kadets90/Real-Time-Cooperative-Decentralized-Control-of-Illumination-Systems-/relatorio.pdf

Instituto Superior Tecnico ´

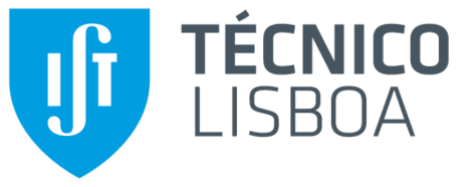
[picture p1: figure]

Sistemas de Controlo Distribuído em

Tempo-Real

### MEEC

2019/2020 - 5o Ano, 1o Semestre

# Real-Time Cooperative Decentralized Control of Illumination Systems

Grupo 20

## Eduardo Pereira David Ribeiro

79640
84027

## Docentes: Alexandre José Malheiro Bernardino João Pedro Castilho Pereira Santos Gomes Ricardo Adriano Ribeiro

10 de Janeiro de 2020

Sistemas de Controlo Distribuído em Tempo-Real 2019/2020

## Conteúdo

1 Introdução | 1
2 Arquitetura do sistema | 2
3 Inicialização do sistema | 6
4 Controlo | 8
5 Comunicações | 10
6 Resultados | 12
7 Conclusão | 15
8 Divisão do trabalho | 16

Sistemas de Controlo Distribuído em Tempo-Real 2019/2020

Resumo

Este relatório mostra uma proposta para a minimização do consumo de energia da simulação de um escritório baseada num sistema de controlo distribuído. Cada posto de trabalho é composto por um micro-controlador, um LED e uma foto-resistência. O algoritmo consensus é utilizado no cálculo dos duty cycles a serem usados nos LED para um consumo mínimo de energia mas satisfazendo os valores de luminosidade em cada posto de trabalho. Foi também desenvolvido um controlador local para que o sistema consiga reagir a perturbações exteriores. Os arduinos comunicam entre si através do uso do Can bus e com uma aplicação desenvolvida em C++, permite ao utilizador enviar comandos para o sistema através de comunicação série.

Palavras-chave— controlo distribuído, consensus, tempo-real, eficiência energética, arduino

## 1 Introdução

Devido ao elevado consumo energético em escritórios para efeitos de iluminação, este projecto tem como objectivo apresentar uma solução mais viável tanto economicamente, como financeiramente, sem afectar a qualidade da iluminação disponível.

Neste trabalho o objectivo é desenvolver um sistema de iluminarias, com um sensor de luminância e o um sensor de presença associados a cada, que, respeitando os valores mínimos impostos pela norma EN 12464-1, optimize a energia consumida pelo sistema. Para tal é utilizado um sistema de controlo descentralizado, onde cada luminária terá uma referência de duty cicle independente, o qual influencia proporcionalmente a potência consumida. Estas referencias são calculadas a partir do algoritmo de controlo descentralizado consensus. Para garantir que a luminância é mantida ao longo do tempo, mesmo na presença de perturbações e/ou iluminação externa, luz do sol a variar ao longo do dia através de uma janela, por exemplo, é utilizado um controlador proporcional integral local em cada ponto, de forma a que a o valor de luminância seja o mais constante possível. Para a leitura do valor da luminância e respectiva actuação e controlo local será utilizado um arduino em cada ponto. Os arduinos comunicam entre si por CAN bus, e a um computador através de comunicação série.

Sistemas de Controlo Distribuído em Tempo-Real 2019/2020

## 2 Arquitetura do sistema

## 2.1 Circuito

Para simular as luminárias presentes num escritório, usa-se o circuito apresentado na Figura 1. Para se poder monitorizar a quantidade usa-se o circuito recetor também na Figura 1, através do uso de um LDR, resistência dependente de luz. O valor desta resistência em função da luz aplicada na resistência é dada por

LDR(x) = 10m∗log10 x+b
, | (1)

em que m e b representam respetivamente o declive da característica Iluminância/Resistência, que na escala logarítmica é linear, e a interseção do declive no eixo da resistência. Como o processo de fabricação dos LDR não é muito rigoroso, estes dois valores variam dentro de uma certa gama de valores fornecidos na folha de especificações do LDR. Por isso, os valores de m e b foram determinados de forma a se obter uma uma relação entre duty cycle e iluminância o mais linear possível, e que as leituras dos dois sensores fossem semelhantes para a mesma de luz.

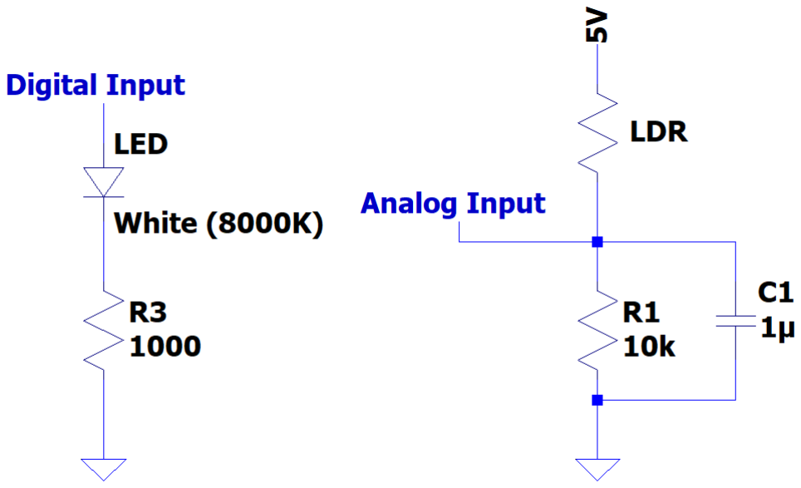
[picture p2: figure]

Figura 1: Esquemático do circuito emissor, à esquerda, e o circuito recetor à direita

Como a variação de iluminância faz variar o valor da foto-resistência, é preciso utilizar um circuito para que o arduino consiga medir esta variação de forma a obter depois a iluminância. Com o circuito recetor, verifica-se que a tensão medida na entrada analógica pode ser obtida utilizando um divisor de tensão é dada por

Sistemas de Controlo Distribuído em Tempo-Real 2019/2020

v = Vcc − i ∗ LDR(x), | (2)

em que x é a iluminância em lux que o LDR capta, Vcc é novamente a tensão de alimentação do circuito e i é a corrente que passa no LDR, que por sua vez é dada pela soma da corrente na resistência R1 e no condensador C1, ou seja,

i =

v
R1

+ C1 ∗

∂v
∂t . | (3)

Ao substituir 3 em 2, resulta em

v˙ ∗ τ (x) = −v + Vcc ∗

R1
R1 + LDR(x)
, | (4)

em que τ (x) é dado por
τ (x) = R1 ∗ LDR(x)
R1 + LDR(x)
∗ C1. | (5)

Resolver a equação diferencial em 4, resulta em

v(t) = vf − (vf − vi) exp −

t − ti
τ (xf )
, | (6)

em que vf e vi são os valores finais e iniciais respetivamente de v, ti é o instante de tempo em que o valor de x muda e xf é o valor final de x.

## 2.2 Caracterização do LDR

Para se saber a relação entre a iluminância e o duty cycle aplicado é necessário determinar os parâmetros m e b da equação (1). Para tal, foram medidos varios valores da tensão à saida do circuito recetor para diferentes valores de duty cycle. A partir da equação (divisor de tensão da Figura 1)

LDR = (Vcc
v
− 1) ∗ R1 | (7)

é possível obter a resistência no LDR, e assim obter a iluminância a partir de

x = (LDR
10b

)

1
m . | (8)

Como b é o offset entre a resistência e a iluminância seria necessário saber a que iluminância esta sujeito o LDR para se poder determinar. Como tal, este parâmetro foi apenas determinado de forma a que o conjunto tivesse valores similares para a mesma condição de luz. Para determinar m, com os pontos recolhidos, determinou-se a correlação

Sistemas de Controlo Distribuído em Tempo-Real 2019/2020

linear da iluminância x com o PWM (Pulse Width Modulation, é utilizado no lugar do duty cicle, é dado por numa palavra de um byte), para diversos valores de m (entre o mínimo e máximo possível dados pela datasheet), escolhendo-se no final o que apresentar maior correlação. Na Figura 2 pode-se observar um gráfico com a correlação obtida em função de m.

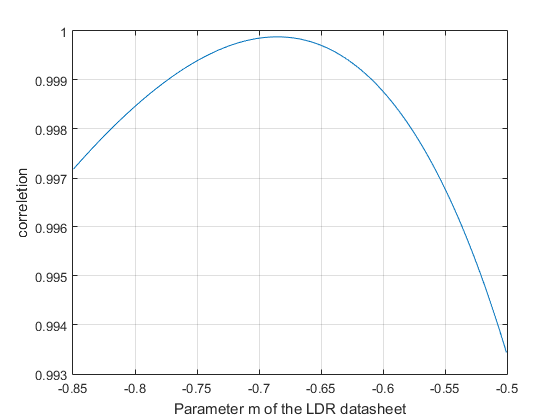
[picture p3: figure]

Figura 2: Determinação do m que melhor correlaciona linearmente a iluminância com o PWM.

## 2.3 Determinação do tempo de resposta

O sistema em causa é de primeira ordem, e pode ser descrito por

G(x) = K0(x)
1 + sτ (x)
. | (9)

Para se determinar o tempo de resposta do circuito τ (x), em resposta a uma alteração ao PWM de referência, aplicaram-se diferentes steps (Figura 3 e traçou-se uma reta do tempo de resposta em função dos PWM aplicados.

Sistemas de Controlo Distribuído em Tempo-Real 2019/2020

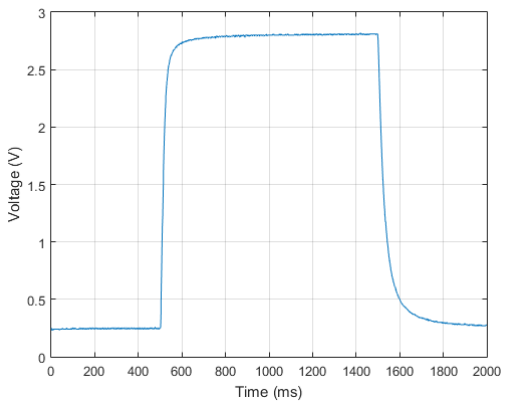
[picture p4: figure]

Figura 3: Na figura pode-se observar um step crescente aos 500 ms e um negativo aos 1500 ms.

Na Figura 4 pode-se observar os tempos de resposta em função do PWM. A esquerda ` tem-se step de 0 para o valor presente no eixo horizontal, e à direita o inverso.

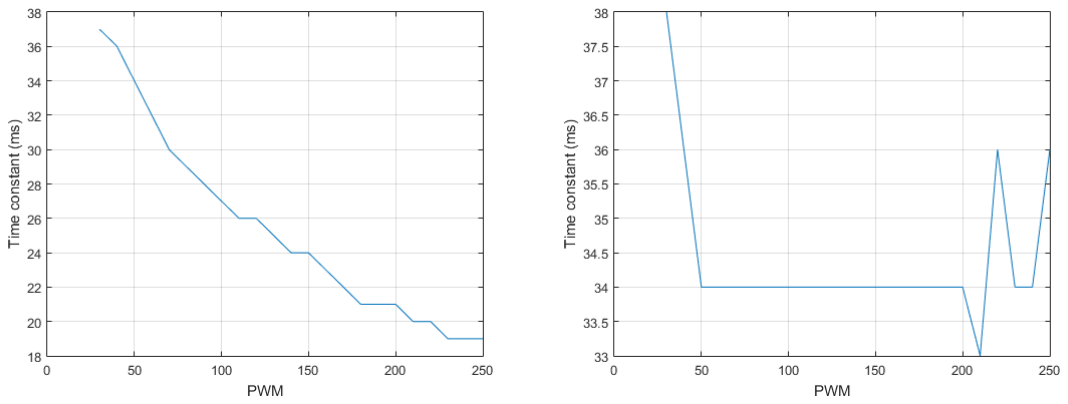
[picture p5: figure]

Figura 4: Tempo de resposta em função do PWM.

Assim assumiu-se que quando o step é crescente a constante de tempo varia linearmente com o PWM, e quando é decrescente se mantém constante.

Sistemas de Controlo Distribuído em Tempo-Real 2019/2020

## 3 Inicialização do sistema

Quando se inicializa o sistema cada elemento envia uma mensagem para reiniciar o sistema, de forma a que o sistema seja imediatamente calibrado. O sistema desenvolvido sabe o número de elementos que serão inseridos na rede, mas poderia não saber, para tal bastaria adicionar um vector com o numero máximo de elementos que o sistema aceita, e quando se faz a calibração guardar a informação dos elementos que de facto estão na rede, e os que não estão. Esta solução obrigaria a alocar memória para o numero máximo de elementos que o sistema poderia receber, mas como se verá na secção das comunicações, não seria um problema visto que o numero máximo de elementos permitidos é baixo.

Após a inicialização do sistema é necessário determinar a relação entre o PWM e a iluminância. A relação entre ambas é linear, mas a luz de um LED vai influenciar a leitura dos LDRs vizinhos, portanto é necessário também determinar os coeficientes de acoplamento. A iluminância do sistema é dada por

L1
LN

- =

k11 | ... | k1N
kN1 | ... kNN

d1
dN

- +

o1
oN

- , | (10)

onde Li

, di

, oi são a iluminância, PWM e iluminância externa ao sistema na secretária i, e kij o ganho de iluminância em i em função do PWM do LED j.

Assim para se determinar a relação entre PWM e a iluminância é necessário determinar os coeficientes kij e as iluminâncias externas ei
. Para tal, cada elemento lê o valor de iluminância com todos os LEDs desligados para obter a sua iluminância externa oi , e
posteriormente, à vez cada elemento liga o seu LED com PWM máximo, todos os elementos fazem a leitura da iluminância, e o obtém o valor do coeficiente por

kij =

Li − oi
PWMmax
. | (11)

onde j é o elemento com o LED ligado. A organização deste processo pode ser observado no fluxograma da Figura 5.

Sistemas de Controlo Distribuído em Tempo-Real 2019/2020

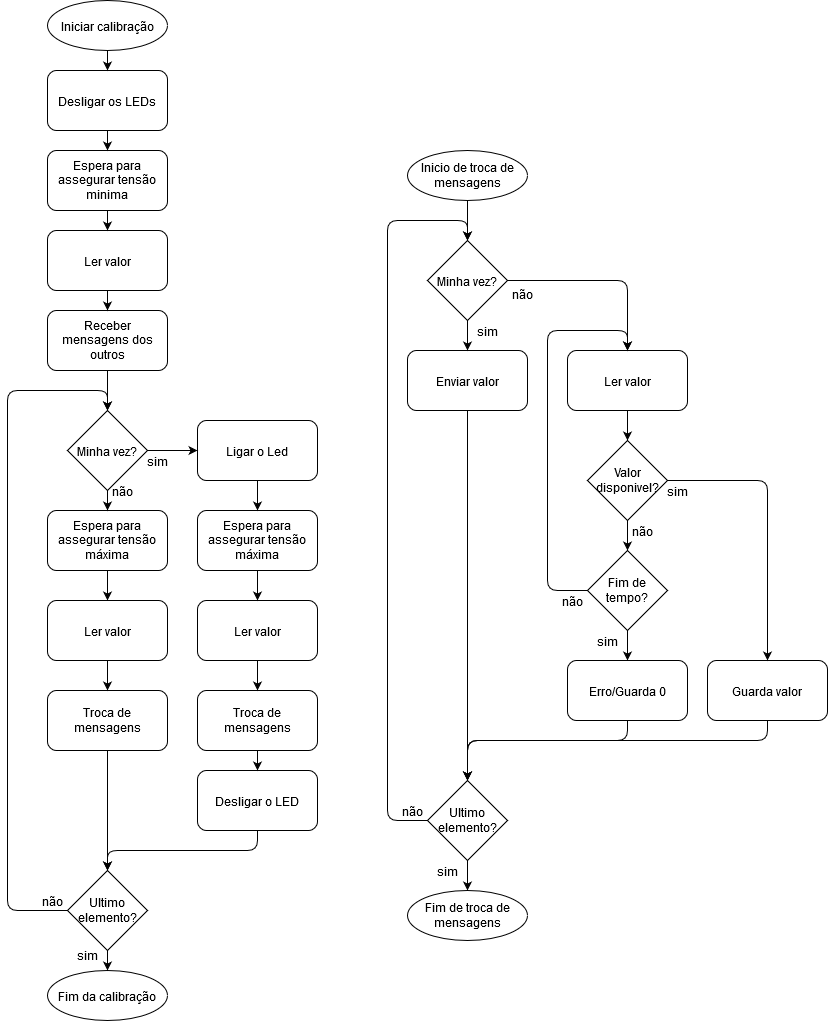
[picture p6: figure]

Figura 5: Fluxograma do processo de calibração.

No fluxograma da Figura 5 pode-se notar que os coeficientes são passados para todos os elementos da rede. Este processo não é necessário ao bom funcionamento do programa, apenas é feito para o utilizador poder ter noção dos valores dos coeficientes de todo o sistema, e não ter acesso a apenas um nó. Para remover esse procedimento será necessário adicionar um tempo de espera para garantir que todos os elementos leram os valores, ou então os elementos que não ligaram o LED enviam um mensagem de verificação em como a leitura já foi efetuada. Todas estas abordagens são síncronas.

Sistemas de Controlo Distribuído em Tempo-Real 2019/2020

## 4 Controlo

## 4.1 Local

Cada elemento tem um controlador local para manter o valor da iluminância desejada, e ser capaz de atuar perante perturbações externas. Na seguinte Figura pode-se observar o diagrama de blocos do controlador local.

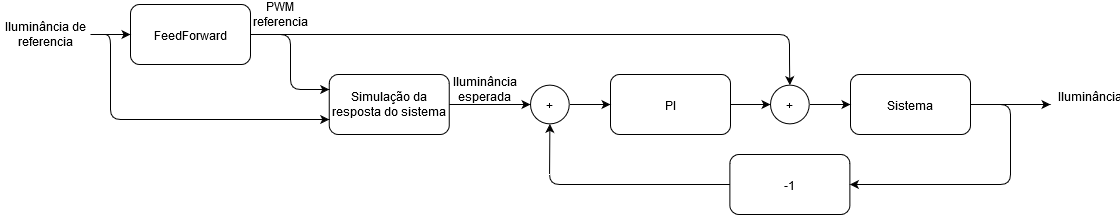
[picture p7: figure]

Figura 6: Esquema de controlo local de cada elemento.

O controlador local procura que a variável de saída siga uma dada referencia de entrada. Para tal o controlador feedforward relaciona a variável de saída com a de atuação do sistema. Assim o controlador responde à iluminância de referencia da entrada, determinando um valor de PWM que gere esse valor de iluminância à saída. O controlador feedforward contudo não tem qualquer capacidade para lidar com perturbações, colocando sempre o mesmo valor à saída para uma dada referencia. Este bloco é totalmente dependente da calibração que foi feita, podendo assim apresentar erro estático em caso de diferenças em relação aos valores determinados inicialmente.

Para resolver os problemas do controlador feedforward adiciona-se um controlador de feedback. Este controlador compara o valor de iluminância à saída com o valor esperado, e utiliza esse valor de erro para determinar como deve atuar sobre o sistema. Para este efeito foi escolhido um controlador proporcional integral (PI). Como o sistema é discreto é necessário utilizar uma transformação, neste caso Tustin, pois não tem atrasos e é a melhor a lidar com ruído. Foi adicionada uma janela de anti-windup, para prevenir que o erro acumulado do integrador fosse demasiado alto, o que pode acontecer devido a uma variação brusca na referencia, ou à referencia estar fora do alcance do sistema. Para diminuir os erros de quantificação (conversor A/D tem uma resolução de 1024 bits para um alcance 5V) poderia-se adicionar um filtro passa baixo, fazendo a média das ultimas amostras.

Por fim o simulador de resposta do sistema utiliza a equação (6) para determinar o valor de iluminância esperada ao longo do tempo. Este bloco permite que o valor do erro calculado no controlador de feedback seja mais perto do real, visto que o sistema não tem uma resposta imediata à alteração de referência.

Sistemas de Controlo Distribuído em Tempo-Real 2019/2020

## 4.2 Geral

O algoritmo consensus é utilizado para minimizar o consumo de energia, satisfazendo os valores de luminosidade pedidos em cada luminária simulada. Trata-se de um problema de minimização e pode ser descrito por

min
d

c

T
d

s.t. d ∈ C

, | (12)

em que
d = [d1 · · · dN ]

T
(13)

e
c = [c1 · · · cN ]

T
(14)

são respetivamente os duty-cycles associados a cada LED e os custos associados a cada luminária e
C : {d : ∀i, 0 ≤ di ≤ 100 e kT
i d ≥ Li − oi} | (15)

representa a feasible region, Li

, oi e ki são respetivamente o limite inferior de luminosidade do nó i, a luminosidade externa medida no nó i e

ki = [ki1 · · · kii · · · kiN ]

T
(16)

que representa a influência do nó i nos outros nós. O algoritmo consensus permite a separação a função do problema de minimização, ou seja, cada nó precisa apenas dos seus próprios valores de L, o e k para calcular a solução ótima. Para obter esta solução, o algoritmo ADMM (alternated direction method of multipliers, que usa o método augmented Lagrangian, é aplicado em cada iteração para que o nó i possa obter os valores de dutycycle. A minimização distribuída usando o augmented Lagrangian baseia-se nos seguintes cálculos em cada nó:

1. di(t + 1) = argmindi∈Ci

{c

T
i

di + y

T
i

(t)(di − di(t)) + ρ
2

||di − di(t)||²
2

}

2. di(t + 1) = 1
N

PN
j=1 dj (t + 1)
3. yi(t + 1) = yi(t) + ρ(di(t + 1)) − di(t + 1))

em que t é o número da iteração, di é uma cópia da solução média de todos os nós e ρ é um parâmetro do método. Baseado em (2), a iteração di(t + 1) é dada por

di(t + 1) = argmind∈C{

1
2

ρdT
i di − d

T
i
zi(t)} | (17)

com zi(t) = ρdi(t) − ci − yi(t)

Este algoritmo permite calcular a solução para este problema de otimização com restrições de forma descentralizada. Esta descentralização permite uma poupança em termos de memória nos arduinos, já que cada arduino precisa apenas de calcular a sua solução.

Sistemas de Controlo Distribuído em Tempo-Real 2019/2020

## 5 Comunicações

O sistema é composto por uma rede de arduinos ligados entre si por Can bus, e um dos quais, Hub, está ligado a um computador por porta serie. O utilizador poderá monitorizar e dar ordens ao sistema a partir de uma aplicação de computar, a qual recebe e envia toda a informação para o sistema através do Hub. Cada arduino guarda as suas informações, exceto os buffers com a informação da iluminância e PWM ao longo do ultimo minuto, as quais são enviadas constantemente para o computador.

## 5.1 Comunicação entre arduinos

A comunicação entre os vários elementos da rede é feita através de Can bus (Controller Area Network). A comunicação é descentralizada, e todos elementos se encontram ligados à rede, sendo a transmissão de mensagens feita através de Broadcast, cabendo a cada elemento da rede decidir através do identificador da mensagem se a lê ou não. Não existe limitação no numero de elementos ligados à rede, sendo possível adicionar ou remover elementos facilmente à rede. O controlo de erros é feito por CRC (Cyclic Redundancy Check), sendo a probabilidade de erro não detatado inferior a 4.7 ∗ 10⁻¹¹

As mensagens são limitas a tem um tamanho máximo de 134 bits em modo standard, dos quais 5 bytes são para o identificador e 8 bytes para o conteúdo. Assim foi definido o seguinte protocolo de comunicação

Mensagem | Descrição | ID de destino | memória (byte)
r | Informação para reiniciar o sistema | BROADCAST | 1
q | Informação para correr o consensus | BROADCAST | 1
g X | Pedir o parametro X ao arduino ID | ID | 3
Xjvalue | Parametro X e o respetivo valor do elemento j | BROADCAST | X - 1, ID - 1, value - 1 a 6
Ijvalue | Iluminância do elemento j | ID | I - 1, ID - 1, value - 1 a 6
djvalue | PWM do elemento ID | ID | d - 1, ID - 1, value - 1 a 6
sXvalue | Alterar X para o valor recebido | ID | s - 1, X - 1, value - 1 a 6
Hj | Identificador do HUB | BROADCAST | H - 1, ID - 1 a 7

Onde cada elemento apenas aceita as mensagens com o seu identificador (buffer 1 de receção) ou as de Broadcast (ambos os buffers de receção). A caractere X representa um de vários parâmetros disponíveis para cada elemento, desde ocupação (’o’), iluminância de referência (’r’), energia gasta (’e’), ou erro de visibilidade (’v’). O caractere j representa o identificador do emissor da mensagem. Isto é necessário pois o HUB com o identificador da

Sistemas de Controlo Distribuído em Tempo-Real 2019/2020

mensagem apenas sabe identificar que a mensagem é para ele, não sabendo a sua origem. Essa identificação é feita através de um caractere, o que aumenta o numero de endereços disponíveis de 10 para mais de 200. Por fim o value tem disponíveis 6 bytes para poder escrever o seu valor.

Cada mensagem em modo standard tem no máximo 134 bits, sendo que a velocidade de transmissão é de 1 Mbps consegues-se obter assim um numero mínimo aproximado de 7463 mensagens por segundo. Sabendo que o sistema tem de correr a 100 Hz, tem-se que o numero máximo de mensagens por período é de 74. Como em cada período cada elemento tem de enviar os seus valores de iluminância e PWM ao HUB, e pode ser necessário que cada elemento envie uma mensagem numa dada altura a pedido g X T, tendo assim que cada elemento (exceto o HUB) tem de poder enviar pelo menos 3 mensagens por período. Assim tem-se que o numero máximo de elementos é de 24 elementos. Na prática será ainda menor pois é necessário tempo para o controlo local, calculo de parâmetros, bem como enviar e receber mensagens pela porta serie na comunicação com a aplicação.

## 5.2 Comunicação entre Computador e sistema

A comunicação do computador com o sistema de arduinos é baseado na biblioteca Boost Asio, que permite implementar funções de I/O assincronamente, através de uma aplicação desenvolvida em C++. A função async write permite a escrita de uma string que contém o comando desejado num buffer, que por sua vez é enviado para um dos arduinos para que o comando possa ser processado. A função async read until permite a leitura da string que o arduino envia, que é escrita noutro buffer diferente e esta string é enviada para a consola. Para facilitar as comunicações entre o computador e o sistema, os cálculos necessários para certos comandos são todos feitos nos arduinos e assim só é preciso enviar a string com a resposta desejada para cada comando, a custo de um uso da memória quase
total dos arduinos. E que os ´ | buffers de dados são alocados na aplicação devido a falta de
memória nos arduinos. A comunicação é realizada por porta série, e em caso da aplicação não conseguir abrir a porta, retorna uma mensagem de erro para a consola. Foram também implementadas condições de break para alguns comandos, para garantir que não chegam strings não desejadas à consola da aplicação. A utilização de funções assíncronas permite o envio de comandos para os arduinos e leitura de mensagens sem que um comprometa o outro, sendo feitas assincronamente. Por outro lado, isto implica que sejam protegidas as estruturas de dados bem como a leitura e escrita na porta série, para não haver tentativas de acesso em simultâneo, levando a erros de leitura ou escrita.

No desenvolvimento da aplicação foram usadas threads para definir a tarefa de escrita e de leitura, para permitir que as funções fossem assíncronas, podendo enviar ou receber
mensagens do arduino sem uma ordem especifica. E usado o máximo ´ | baud rate de 250000
para que as comunicações possam ser o mais rápido possível.

Sistemas de Controlo Distribuído em Tempo-Real 2019/2020

## 6 Resultados

No controlo local foram observadas as resposta do sistema para os diferentes componentes do mesmo. Todos os testes foram feitos utilizando duas referencias fixas, 10 lux para o estado low e 40 lux para o estado high.

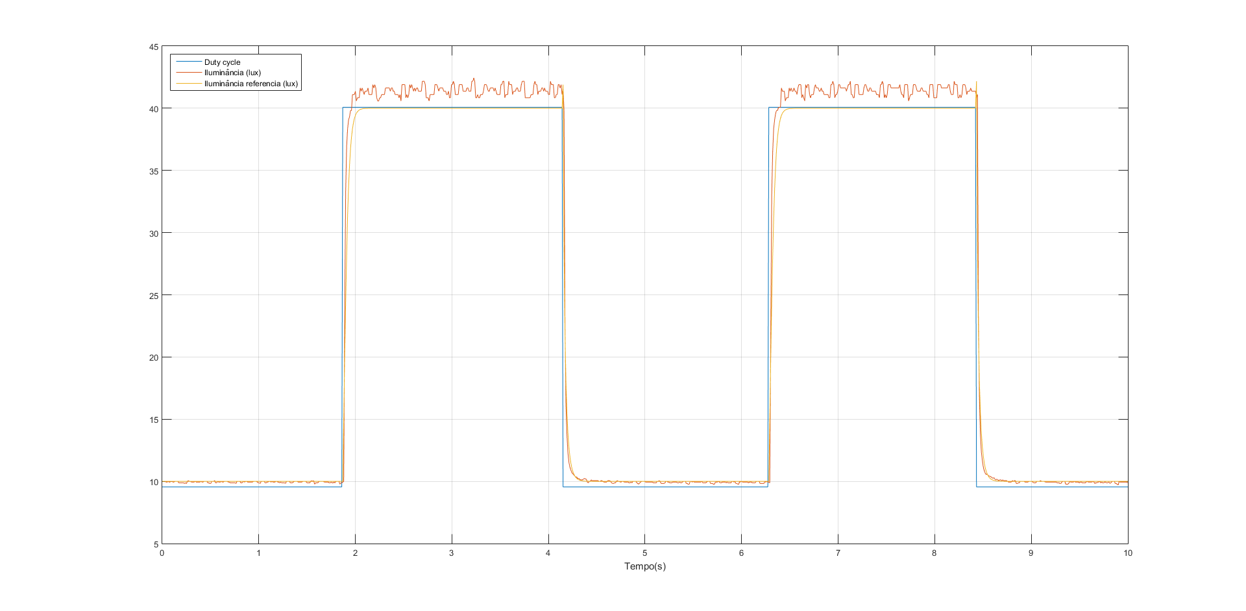
[picture p8: figure]

Figura 7: Resultados obtidos com o controlador feedforward.

Na Figura 7 pode-se observar a resposta do sistema utilizando apenas um controlador feedforward. Pode-se notar que o sinal de saída tem um desvio em relação à referencia. Isto deve-se a um calibração defeituosa. E também possível notar oscilações no valor da ´ iluminância lida, as quais poderiam ser atenuadas utilizando um filtro passa baixo que fizesse a média das últimas leituras. O tempo de resposta obtido foi em média de 20 ms.

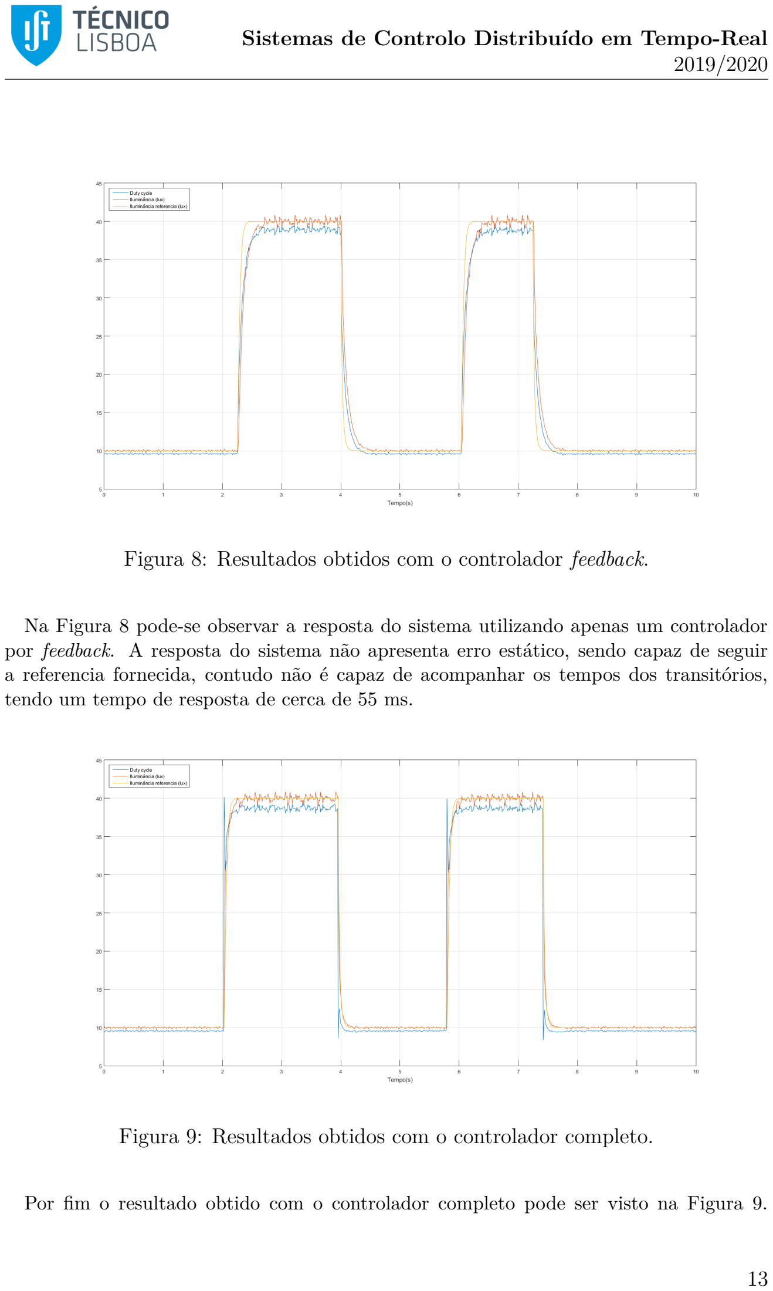
[picture p9: page 15]

Sistemas de Controlo Distribuído em Tempo-Real 2019/2020

Figura 8: Resultados obtidos com o controlador feedback.

Na Figura 8 pode-se observar a resposta do sistema utilizando apenas um controlador por feedback. A resposta do sistema não apresenta erro estático, sendo capaz de seguir a referencia fornecida, contudo não é capaz de acompanhar os tempos dos transitórios, tendo um tempo de resposta de cerca de 55 ms.

Figura 9: Resultados obtidos com o controlador completo.

Por fim o resultado obtido com o controlador completo pode ser visto na Figura 9.

Sistemas de Controlo Distribuído em Tempo-Real 2019/2020

Neste é possível notar um overshoot no duty cycle quando se dá a mudança de referência que não acontecia no controlador por feedback, pois o controlador por feedforward altera instantaneamente. Pode-se notar também que a resposta é mais rápida em relação ao controlador por feedback (cerca de 30 ms de tempo de resposta), acompanhando o valor de iluminância esperada ao longo do transitório.

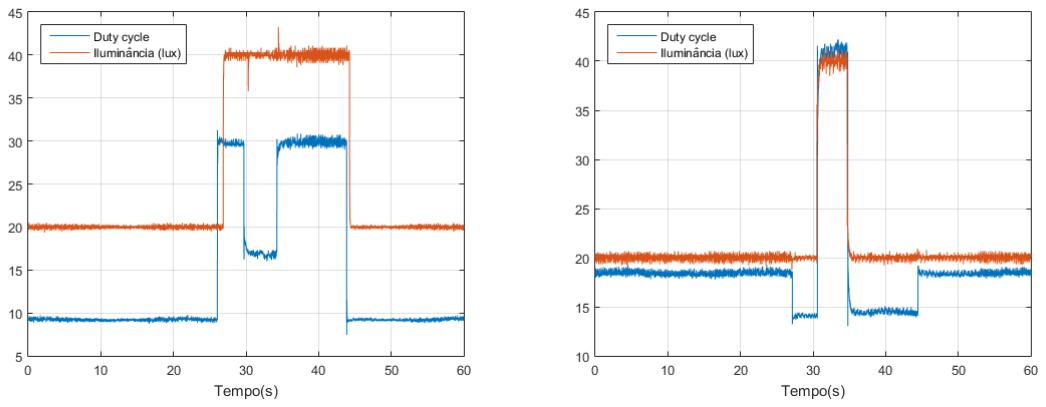
[picture p10: figure]

Figura 10: Variação do duty cycle e da iluminância com o tempo.

Os resultados para o controlador geral podem ser vistos na Figura 10. Nele é possível observar várias mudanças de referencia em dois elementos ao longo do tempo, e que o sistema é capaz de se adaptar, alterando a iluminância disponível num, sem intervir com a
iluminância do outro. E possível notar alterações ao ´ | duty cycle de um elemento, sem que
este altere a sua iluminância, devido à iluminância que lhe passou a ser disponibilizada pelo outro elemento. Isto deve-se ao facto de o controlo distribuido feito pelo consensus calcular referencias novas para o duty cycle de ambos que permita obter a iluminância desejada em ambos os pontos, sem que a alteração de uma provoque uma perturbação na outra. Nota final para o facto de o duty cycle na figura da esquerda estar ligeiramente avançado em relação à iluminância. Isto acontece pois alguns pontos são perdidos, durante a comunicação entre arduinos, ficando o buffer que guarda as iluminâncias lidas no ultimo minuto com mais pontos que o buffer que guarda o valor do duty cycle.

Sistemas de Controlo Distribuído em Tempo-Real 2019/2020

## 7 Conclusão

A solução apresentada mostra uma simulação de um sistema de controlo distribuído de forma a minorar o consumo de energia num escritório. E de reforçar a importância ´ que a minimização de energia apresenta num caso real, quer seja por razões monetárias ou razões ambientalistas. A aplicação baseada na biblioteca Boost Asio apresenta uma inovação de comunicação assíncrona com o arduino, visto que a maioria de aplicações usando as bibliotecas da Boost são baseadas em sockets. O sistema está preparado para lidar com mais arduinos, sendo que a implementação de mais nós mas acabou por não ser experimentado.

O controlo do sistema é robusto, sendo capaz de lidar com variações na ocupação das secretárias, calculando novas referencias a partir do algoritmo consensus, e mantendo a iluminância praticamente inalterada.

Existem uns quantos pontos possíveis a melhorar no sistema completo. Um problema a resolver na aplicação será garantir que o comando de escrita e leitura dos arduinos sejam exclusivos, ou seja, que os comandos não se sobreponham, que pode ser resolvido com a utilização de mutexs. Outra melhoria seria não ter de definir o numero de arduinos do sistema, para facilitar a adição ou remoção de elementos. Finalmente, como o valor de iluminância exterior varia ao longo de um dia, principalmente em espaços com luminosidade exterior, para garantir o menor custo possível deveriam ser feitas calibrações periodicamente para garantir que os coeficientes são os mais corretos, não deixando apenas a cargo do controlador local, avaliando por exemplo o valor médio das correções do controlador local ao final de um certo intervalo de tempo.

Sistemas de Controlo Distribuído em Tempo-Real 2019/2020

## 8 Divisão do trabalho

O trabalho desenvolvido foi distribuído pelos diversos elementos da forma que a seguir se apresenta.

Divisão do trabalho desenvolvido:

- David Ribeiro - controlador local e global, comunicações entre elementos da rede, aplicação e comunicação serie, calibração e inicialização;
- Eduardo Pereira - controlador local, aplicação e comunicação serie, calibração e inicialização.

Divisão das secções do relatório:

- David Ribeiro - introdução, caracterização do LDR, determinação do tempo de resposta, controlador local, comunicações entre elementos da rede, calibração e inicialização, resultados, conclusão;
- Eduardo Pereira - resumo, introdução, circuito, controlador global, aplicação e comunicação serie, conclusão.

Sistemas de Controlo Distribuído em Tempo-Real 2019/2020

## Referências

[1] Electronic, Lida Optical &, Cds Photoconductive Cells Gl5528, 2014, https://pi.gate.ac.uk/pages/airpi-files/PD0001.pdf
[2] Alexandre Bernardino, Solution of Distributed Optimization Problems: The consensus algorithm,2018
